Manas-36/VANITRA/docs/report/README.md

# Reports

| File | What |
|---|---|
| [Vanitra_Blue_Book_SCS_2025-26.pdf](Vanitra_Blue_Book_SCS_2025-26.pdf) | Project report (blue book), SCS mini project, AY 2025-26, guide Dr. Archana Belge |
| [Vanitra_Blue_Book_cover_and_index.pdf](Vanitra_Blue_Book_cover_and_index.pdf) | Cover page + chapter index template (6 chapters) |
| [paper/Vanitra_IEEE_paper_v2_Oct2025.pdf](paper/Vanitra_IEEE_paper_v2_Oct2025.pdf) | IEEE-format paper, latest version (Oct 2025) |
| [paper/Vanitra_IEEE_paper_v1_Aug2025.pdf](paper/Vanitra_IEEE_paper_v1_Aug2025.pdf) | First version (Aug 2025) |
| [ERRATA.md](ERRATA.md) | 21 fixes to make before resubmitting (pin counts, IMU, STT claim, captions, spelling, references) |

These describe the **first prototype** (breadboard glove + Wokwi). The v1.0 design in this repo differs where the errata say so; the design reasons are in [../decisions.md](../decisions.md).
When the v1.x hardware is measured ([../testing.md](../testing.md)), update Chapter 4 (pin map, schematics from `docs/wiring/`), Chapter 5 (new results) and the paper's Section VI.

Figures in `docs/images/` were extracted from these PDFs (CAD, prototype photos, Wokwi, old block diagrams `*_old.png`). The new schematics are in `docs/wiring/`.
