Manas-36/VANITRA/docs/images/README.md

# Images

Extracted from the 2025 blue book, IEEE paper and Hackanova deck.

| File | What |
|---|---|
| `prototype_glove.png`, `prototype_bench.png` | first breadboard prototype (SCS mini project) |
| `cad_glove.png`, `cad_wristband.png`, `cad_wristband_top.png` | CAD renders |
| `glove_labelled.png`, `wristband_labelled.png` | labelled component placement |
| `wokwi_glove.png`, `wokwi_wristband.png` | Wokwi simulations (old pin map) |
| `pcb_layout_glove.png` | early single-layer PCB layout (ESP32-S3-WROOM-1 + OLED header) |
| `comparison_table.png` | comparison with existing systems (paper Table 1) |
| `block_*_old.png`, `flow_*_old.png` | original block diagrams / flowcharts — superseded by `docs/wiring/system_overview.png` |
