Manas-36/VANITRA/docs/decisions.md

# Design decisions

Why the v1.0 design looks the way it does. Several decisions resolve contradictions between the SCS blue book, the IEEE paper and the Hackanova deck (listed in [report/ERRATA.md](report/ERRATA.md)).

## D1 — One pin map, owned by the firmware
**Problem.** The Hackanova deck put 5 flex sensors on "GPIO 4–7" (4 pins) and Hall sensors on "GPIO 9–13" (5 pins). The blue book said 2–4 Hall sensors.
**Decision.** Use **5 flex sensors on GPIO 4, 5, 6, 7, 8** and **4 Hall sensors on GPIO 9, 10, 1, 2**, all on ADC1 (ADC2 is not used). The pins are defined in `firmware/*/config.h`, and the schematics and [wiring.md](wiring.md) copy them. Four Hall sensors match the Wokwi model, which had 4 contact inputs.

## D2 — The IMU is a core sensor, not optional
**Problem.** The blue book called the MPU6050 "optional", while the paper and deck treat it as core.
**Decision.** It is **core**. Six of the 16 model features (roll, pitch, their change, gyro mean/max, accel spread) come from it. Without it, static hand shapes still work, but signs that differ only in motion (YES vs SORRY, GOOD vs BAD) cannot be told apart. The firmware still runs if the IMU is missing, so that wiring faults are easy to find.

## D3 — Analog Hall sensors (SS49E) instead of digital switches
The paper's formula is `if V_hall > V_threshold → contact`, which needs an analog output. Common A3144 switches also need ≥ 4.5 V. The **SS49E** is linear, runs on 3.3 V and is cheap. The firmware stores each sensor's no-magnet baseline during calibration and uses **|V − baseline|** with hysteresis (on > 250 mV, off < 150 mV), so either magnet pole works.

## D4 — The wristband recognises a fixed phrase list, not open dictation
**Problem.** The paper claimed "offline speech-to-text" with 85–90 % word accuracy on an ESP32-S3. General dictation on a microcontroller is not realistic, and judges will ask about it.
**Decision.** Use Espressif **ESP-SR** (WakeNet + MultiNet), which runs fully offline on the ESP32-S3 with PSRAM. It recognises up to 200 pre-defined phrases. v1.0 ships **49 phrases → 22 meanings** (`firmware/wristband_unit/phrases.csv`). This is the "keyword detection" framing the Hackanova deck already used. To add phrases, edit the CSV and run `tools/make_sr_commands.py`.

## D5 — Electret + preamp → INMP441 I2S microphone
ESP-SR expects clean 16 kHz digital audio over I2S. The INMP441 is digital, costs about the same as an electret + MAX9814, and avoids ADC noise. The wiring follows Espressif's reference example (SCK 17, WS 47, SD 16).

## D6 — Vibrate short codes, not whole sentences
At a comfortable 120 ms dot, Morse runs at about 10 words per minute, so a full sentence would take 15–30 s. Each meaning therefore has a **short code** of 1–6 characters ("are you okay" → `OK?`, "do you want water" → `WATER?`). A message takes **1–8 s** at normal speed (measured from `morse.h` timings). Danger phrases ("watch out") use a special pattern of three long buzzes that cannot be mistaken for a letter. There are three speeds (160/120/90 ms dot), changed by holding the button.
**Morse timing vs. the deck.** The deck said 50 ms dots and 150 ms dashes. A coin ERM motor needs about 30–50 ms just to spin up, so 50 ms dots are hard to feel. v1.0 starts at a 160 ms dot (learning) and lets the user speed up.

## D7 — The wristband output is haptic Morse, with optional OLED text
**Problem.** The reports said haptic Morse, but the deck's block diagram ended in "Text" and its plan mentioned "text on display".
**Decision.** **Morse vibration is the primary output** (silent, works without looking). A 0.96" OLED is **optional** on both units: on the wristband it shows the full sentence, and on the glove it shows the word being spoken so the signer can confirm it. The firmware detects at runtime whether an OLED is fitted.

## D8 — Glove speech = recorded clips over I2S, not a buzzer
The glove must say real words offline. Pre-made WAV clips (16 kHz mono, about 450 KB for 20 words) are embedded in flash and played through a **MAX98357A** I2S amplifier. `ml/make_voice_clips.py` creates them with espeak-ng, or from your own recordings, which sound much better. There is no runtime TTS and no SD card.

## D9 — Our own tiny neural network instead of TensorFlow Lite
The model is a 16→32→21 MLP (about 1,200 multiply-adds, well under 1 ms). It is exported by `ml/train.py` as plain C arrays (`model.h`) and run by about 40 lines of C++ (`mlp.h`). This avoids the TFLite toolchain, keeps the firmware easy to read, and lets the PC test check that the C++ output **matches Python to 1e-6**. TFLite Micro (bundled with core 3.x) remains an option if a 1D-CNN is needed for continuous signing.

## D10 — Window features instead of raw frames
The features are the mean flex per finger, the fraction of time each Hall sensor is in contact, roll/pitch and their change, and gyro mean/max and accel spread over **0.5 s**. They cover static signs (shape) and simple dynamic signs (motion) with only 16 numbers, which suits a small dataset collected by students. The window, features and model are all fixed in one place (`features.h` ↔ `vanitra_features.py`).

## D11 — REST class + confidence gate + stability
Real use is mostly "no sign". Without a REST class and a gate, the glove would talk all the time. A word is spoken only when the model says the same non-REST label with p ≥ 0.85 **three times in a row** (300 ms). The same word is not repeated unless the hand returns to REST or 2.5 s pass. All of these are `#define`s in `config.h`.

## D12 — Same board for both units
Both units use the **ESP32-S3-DevKitC-1 N16R8**. ESP-SR needs the PSRAM, the glove gets room for clips and future models, and one spare board covers both units.

## D13 — Power: 1S LiPo → TP4056 → MT3608 (5 V) → board 5V pin
These are cheap, easy-to-find modules. The board's own regulator makes 3.3 V. The amplifier runs directly from 5 V for volume. The battery voltage is read through a 100k/100k divider. Estimated runtime on 1000 mAh is about 8 h (glove) and about 5 h (wristband; ESP-SR keeps the CPU busy). These are estimates to be measured (see [testing.md](testing.md)).

## v2 decisions (Oct 2026), from the [design review](design_review_v2.md)

## D14 — Keep resistive flex sensors, but 4.5″ on the fingers and mounted properly
Alternatives were compared in the review. Finger IMUs cannot see bend when the palm faces sideways without gyro integration or magnetometers, and the fingertip magnets would upset magnetometers. Knuckle Hall sensors would cross-talk with those magnets. Capacitive sensors are too expensive. **Decision:** keep the 2.2″ sensor on the thumb and use **4.5″** on the index to little fingers, because they cover both knuckles and tolerate the glove shifting. Anchor only the pin end, slide the strip in a sleeve, and stiffen the pins. Divider **R = √(R_flat·R_bent)**: 22 kΩ for 4.5″ and 33 kΩ for 2.2″. Budget option: 2.2″ everywhere.

## D15 — 100 nF on every analog input
The ESP32-S3 SAR ADC samples onto a small internal capacitor through a multiplexer. Driven from a 7–15 kΩ Thevenin source, it does not settle fully between channels. A 100 nF capacitor at each pin acts as a charge reservoir, so the reading settles and neighbouring fingers stop leaking into each other. The corner frequency stays above 100 Hz, which is far faster than a finger moves.

## D16 — Glove power without a boost converter
**LiPo → TP4056 + DW01 → switch → VSYS → AP2112K-3.3 / ME6211C33 LDO → board 3V3 pin.** The MAX98357A runs from VSYS (2.5–5.5 V; about 0.8 W into 8 Ω at 3.7 V, which is enough for speech). The flex and Hall readings are ratiometric to 3V3, so the sensor rail should be quiet and steady. A linear regulator gives that, while a 1.2 MHz boost followed by an LDO does not. The cost is runtime: below about 3.5 V the LDO drops out, and the firmware warns at `VBAT_LOW_V`. The battery divider now sits after the switch. The wristband keeps its MT3608 for now.

## D17 — Say "sensor fault" instead of guessing
A flex pin stuck below 120 mV (open: cracked sensor or broken wire) or above 3150 mV (short) for more than 0.5 s sets a fault bit. The glove shows `SENSOR FAULT / FLEX n`, beeps and logs it, and `i` prints the fault mask. Low battery is reported the same way.

## D18 — Temporal CNN as the default model; the MLP stays selectable
The v1 MLP sees 0.5 s reduced to 16 averages, so it cannot tell the order of a movement and only sees part of most signs. **Decision:** use a 1D-CNN on 1.0 s of the raw 15-channel signal. It has 3 conv layers, global mean+max pooling and a dense layer, with about 10 k weights and about 0.23 M multiply-adds. It is trained in **NumPy** (`ml/vanitra_cnn.py`), with augmentation for speed, drift, IMU tilt and noise. It is exported as C arrays and run by `cnn.h`, with the same parity-test approach as D9. `GESTURE_MODEL` in `config.h` switches between the two. `train_cnn.py` scores both on the same folds, so the team ships whichever wins on real data.

## D19 — The glove unplugs from the cuff
**J1** (JST-PH 6p: 3V3 + 5 flex) and **J2** (JST-PH 6p: 3V3, GND, 4 Hall) carry the sensors. The IMU sits on the cuff side of **J3** (JST-SH 4p). The dividers and capacitors stay on the cuff. The fabric glove can then be washed, and a broken sensor can be swapped in minutes.

## D20 — A PC live decoder for demos and tuning
`ml/live_decoder.py` runs the exported CNN with the firmware's exact speaking rules on the serial stream, or on a recorded CSV. It shows live top-3 guesses and a transcript, and can speak aloud. It lets you demo on a projector and tune `CONF_THRESHOLD` / `STABLE_COUNT` without reflashing.

## v3 decisions (Oct 2026): two gloves, ISL grammar, phone camera, from [isl_language.md](isl_language.md)

## D21 — Two gloves, one firmware, ESP-NOW
ISL uses both hands, and most of its alphabet is two-handed, so a single glove caps the vocabulary. **Decision:** build a second, identical glove without the amp, speaker or OLED, and flash the **same sketch** on it. A serial command `r` stores its role (LEFT) in flash. The LEFT glove sends each calibrated frame (36-byte packet, 50 Hz, ESP-NOW broadcast filtered by `LINK_PAIR_ID`) to the RIGHT glove. The RIGHT glove runs the model on 30 channels. A frame older than 120 ms counts as "left missing" (zeros), and training randomly drops the left glove, so recognition degrades to one-handed instead of failing. No router or pairing is needed. Cost: the radio stays on, which roughly halves battery life (measure it). The left glove is about ₹6,500 extra.

## D22 — One ISL gloss vocabulary for gloves and camera
`ml/vocabulary.csv` now holds 58 ISL glosses + REST, chosen to cover everyday, health and emergency sentences, questions, negation and time. Gloves and camera share it, so their probabilities can be fused. Signs are copied from ISLRTC dictionary videos and are deliberately not described in text.

## D23 — Sentences: a sign spotter, a gloss language model, then rules
Continuous recognition is split into three explainable steps:
1. A **spotter** accepts a sign when the same gloss stays on top (confidence + stability), and keeps its top-4 guesses.
2. A **bigram gloss LM** (interpolated) with beam search picks the most plausible sequence. It may drop a shaky detection.
3. **Rule-based ISL → English** handles time→tense, SOV→SVO, wh/NOT at the end, MUST/CAN, FINISH, articles, possessives and infinitives.

Rules were chosen over a learned translator because there is no parallel data yet. Rules never invent meaning, and every output can be traced to its glosses. Swap in a learned model once thousands of signer-checked pairs exist (training_guide.md §7).

## D24 — Non-manual grammar comes from the camera
Yes/no questions (raised brows) and negation (head shake) are facial in ISL, and gloves cannot see the face. **Decision:** the camera measures them relative to the signer's own neutral face (median while not signing). With gloves only, the user signs the general `QUESTION` sign.

## D25 — The phone camera runs through the browser, decoded on the laptop
The phone page uses `getUserMedia` and needs HTTPS, so the laptop makes a self-signed certificate for its LAN IPs. It sends JPEG frames over a WebSocket with at most 2 in flight, which keeps latency low. The laptop sends back glosses and sentences, which the phone shows and speaks (speechSynthesis). No app is needed. Any OpenCV source (DroidCam, IP Webcam, files) also works. Only landmark features are stored, never images.

## D26 — Camera features are in signing space
MediaPipe Tasks (hands ×2, pose, face blendshapes + head pose) produce 148 features:
- coordinates in a body frame (shoulder midpoint, shoulder width, an x axis from the right to the left shoulder, y down), which makes them invariant to position, distance and mirroring;
- handshape in a wrist-centred frame scaled by hand size;
- hands ordered dominant / non-dominant by matching the pose wrists;
- resampling to 25 Hz, with drop-outs up to 150 ms bridged.

The sign model is the same NumPy CNN family as the gloves (1.6 s window, 96/128/128 filters), so there is one code base to test.

## D27 — Glove + camera fusion is a weighted product of probabilities
`p ∝ p_cam^w · p_glove^(1−w)` on the shared vocabulary, with `w = 0.5` by default and tuned on a validation signer. The two sensors fail differently: gloves miss location and the face, the camera misses occluded fingers and struggles in bad light.

## Open questions
- ~~ASL or ISL?~~ **Decided in v3: ISL** (D22). Remaining question: which regional ISL variant your users sign. The vocabulary uses one-handed ASL-style signs because the glove is on one hand. For Indian users, an **ISL** vocabulary is the obvious next step: change `ml/vocabulary.csv` and record new data. No code changes are needed.
- Should the glove and wristband talk to each other (ESP-NOW)? Useful for confirming spoken words on the wrist. Planned for v2.0.
