Manas-36/VANITRA/docs/report/Vanitra_Blue_Book_cover_and_index.pdf

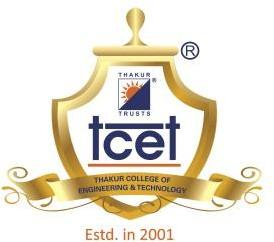
[picture p51: figure]

### Project Report

on

# VANITRA: A Wearable Assistive Device for Bidirectional Deaf–Mute Communication

Submitted in partial fulfilment for the award of the degree of

## BACHELOR OF ENGINEERING

In

## MECHANICAL AND MECHATRONICS ENGINEERING

Submitted by
Shubham Chamedia (2)
Pragati Jha (16)
Manas Pednekar (36)

Under the Guidance of
Dr. Archana Belge
Head of Department

Department of Mechanical and Mechatronics Engineering (Academic Year. 2025-26)

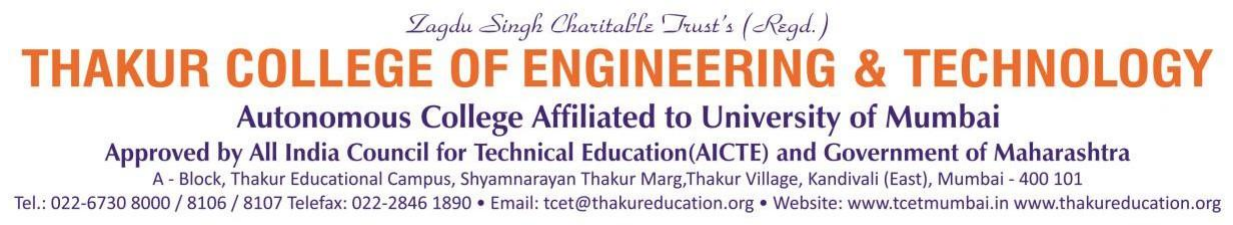
[picture p52: figure]

## Index

Chapter No.: | Topic | Page No.
| Abstract | 1
Chapter 1 | Introduction
| 1.1 Overview of the Project | 2
| 1.2 Motivation & Application | 2
| 1.3 Problem Definition | 2
| 1.4 Objective & Scope | 2
| 1.5 Expected Outcome | 3
| 1.6 Organization of the Report | 3
Chapter 2 | Literature Survey & Proposed System
| 2.1 Literature review of Existing System | 3
| 2.2 Limitations of Existing System & Gap Analysis | 4
| 2.3 Proposed System | 4
Chapter 3 | Requirement Gathering, Analysis and Planning
| 3.1 Requirement Specification | 5
| 3.2 Feasibility Study | 5
| 3.3 Methodology | 6
| 3.4 Technology Stack | 6
| 3.5 Gantt Chart and Process Model | 7
| 3.6 System Analysis (Functional, Structural, and
| Behavioural Models) | 7
| 3.7 Risk Assessment and Mitigation | 8
| 3.8Acceptance Criteria and KPIs | 8
Chapter 4 | System Design and Experimental Set up
| 4.1 System Architecture & Diagrams (DFD/UML/ Block
| Diagram/Physical Layout) | 9
| 4.2 Algorithm & Process flow design (Flowchart/Pseudo
| Code) | 10
| 4.3 User Interface & Input Data Design (Snapshots/
| circuits/Structure) | 11

4.4 Experimental Setup and Tools (Software & Hardware) 12
| 4.5 Implementation, Deployment and Testing | 12
| 4.6 Performance Evaluation. | 13
| 4.7 Summary | 13
Chapter 5 | Results & Discussion
| 5.1 Outputs & Outcomes | 14
| 5.2 Analysis of Results & Interpretation of data | 14
| 5.3 Discussion of Results & Limitations of the System | 15
Chapter 6 | Conclusion & Future Scope
| 6.1 Summary of work completed | 16
| 6.2 Future Scope | 16
| References | 17
| Research Paper
