Manas-36/VANITRA/docs/images/pcb_layout_glove.png

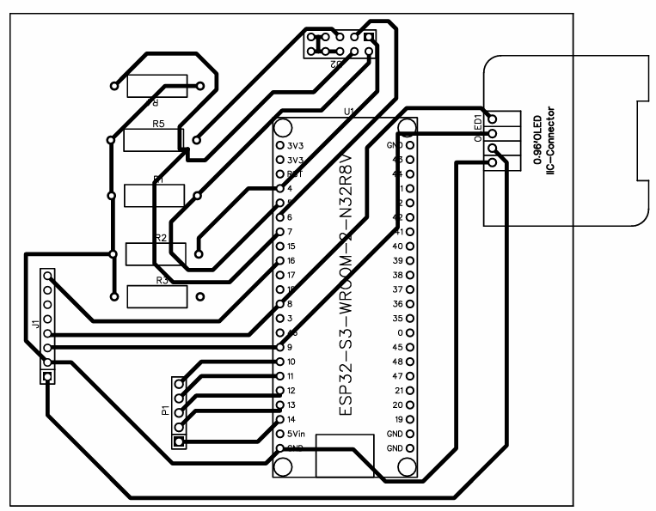
docs/images/pcb_layout_glove.png
