Manas-36/VANITRA/docs/images/wristband_labelled.png

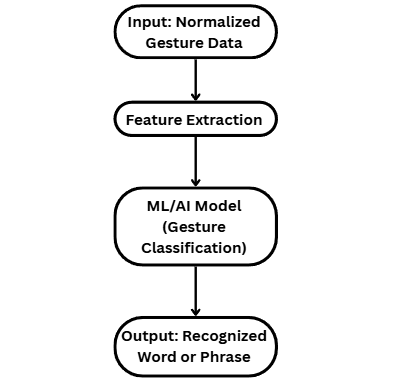
docs/images/wristband_labelled.png
