Manas-36/VANITRA/docs/wiring.md

# Wiring

The schematics are generated by `docs/wiring/make_schematics.py`; re-run it after changing a pin. The SVG files can be zoomed without losing quality. Use the PNG files for slides, the report and Notion. The pins are copied from `firmware/glove_unit/config.h` and `firmware/wristband_unit/config.h`, which are the source of truth.

## System
System overview

## Glove unit (hardware v2)
Glove schematic

v2 changes are explained in the [design review](design_review_v2.md). The v1 drawing is kept as [glove_unit_v1.png](wiring/glove_unit_v1.png).

| Part | Part pin | ESP32-S3 | Notes |
|---|---|---|---|
| Flex thumb (2.2″) | one leg → 3V3, other leg → J1 → **GPIO4**, with **33 kΩ** and **100 nF** → GND on the cuff | GPIO4 (ADC1_CH3) | voltage divider |
| Flex index (4.5″) | same, **22 kΩ** + 100 nF | GPIO5 (ADC1_CH4) | |
| Flex middle (4.5″) | same, 22 kΩ + 100 nF | GPIO6 (ADC1_CH5) | |
| Flex ring (4.5″) | same, 22 kΩ + 100 nF | GPIO7 (ADC1_CH6) | |
| Flex little (4.5″) | same, 22 kΩ + 100 nF | GPIO8 (ADC1_CH7) | |
| SS49E H1 (thumb tip) | VCC 3V3 · GND · OUT → J2 → 100 nF | GPIO9 (ADC1_CH8) | flat face towards the magnet; 100 nF VCC–GND at the sensor |
| SS49E H2 (thumb side, index contact) | OUT | GPIO10 (ADC1_CH9) | |
| SS49E H3 (palm centre, curled fingertips) | OUT | GPIO1 (ADC1_CH0) | |
| SS49E H4 (side of index, touches middle) | OUT | GPIO2 (ADC1_CH1) | |
| MPU6050 (GY-521) | VCC 3V3 · GND · SDA · SCL · AD0 → GND | SDA **GPIO16**, SCL **GPIO17** | address 0x68, back of hand |
| SSD1306 OLED (optional) | VCC 3V3 · GND · SDA · SCL | same I2C bus | address 0x3C |
| MAX98357A | BCLK · LRC · DIN · SD | GPIO12 · GPIO13 · GPIO14 · GPIO21 | **VIN = VSYS (battery after switch) + 100 µF**, GND, GAIN open (9 dB) |
| Speaker | OUT+ / OUT− of the amp | — | 4–8 Ω, never to GND |
| Battery sense | **VSYS** (after the switch) → 100k → **GPIO3** → 100k ∥ 100 nF → GND | GPIO3 (ADC1_CH2) | reads half the battery voltage; no drain when switched off |
| Harness | J1 JST-PH 6p (3V3, F1–F5) · J2 JST-PH 6p (3V3, GND, H1–H4) · J3 JST-SH 4p (MPU6050) | — | the glove unplugs from the cuff for washing / repair |
| BOOT button | on the board | GPIO0 | short = repeat word, hold 2 s = calibrate |
| RGB LED | on the board | GPIO48 (v1.0 board) / GPIO38 (v1.1) | `RGB_BUILTIN` picks the right one |

**Placement on the glove:** flex sensors run along the back of each finger, with the printed side facing out. **Anchor only the pin end** at the knuckle and stiffen the pins (heat-shrink + a small stiffener). The strip slides in a sewn sleeve, with the tip free. Never glue it along its length. Use silicone multi-strand wire. Put **magnets on the fingertips** (index, middle, ring, little) and the **Hall sensors on the thumb tip, the thumb side, the palm centre and between the index and middle fingers**. The MPU6050 goes flat on the back of the hand. The ESP32, amplifier and battery go on the wrist cuff, with the speaker facing outwards.

## Left glove (v3, two-glove mode)
The left glove is the **same circuit as the glove above, without** the MAX98357A, speaker and OLED. It has the same pins, so `config.h` is unchanged. Flash the same `glove_unit` sketch, then type `r` in the serial monitor once. The LED turns **blue** (LEFT) and the right glove stays **green** (RIGHT). The left glove sends its frames over ESP-NOW (Wi-Fi channel `LINK_CHANNEL`, filtered by `LINK_PAIR_ID`). Type `i` on the right glove to see the link: frames received, frames lost, age of the last frame. Any ESP32-S3 board that brings out GPIO 1–10, 16, 17 works for the left glove; it does not need PSRAM.

## Wristband unit
Wristband schematic

| Part | Part pin | ESP32-S3 | Notes |
|---|---|---|---|
| INMP441 mic | SCK | **GPIO17** | |
| | WS | **GPIO47** | |
| | SD | **GPIO16** | mic data out → ESP32 in |
| | L/R | GND | left channel |
| | VDD / GND | 3V3 / GND | |
| Vibration motor driver | MOSFET gate via 100 Ω, 100 kΩ gate → GND | **GPIO4** (PWM 5 kHz) | motor between 3V3 and drain, diode across motor (cathode to 3V3) |
| LISTEN button | one leg → GPIO5, other → GND | **GPIO5** | internal pull-up |
| SSD1306 OLED (optional) | SDA / SCL | **GPIO8 / GPIO9** | 0x3C |
| Battery sense | 100k / 100k divider | **GPIO1** | |
| RGB LED | on the board | GPIO48 | |

Keep the microphone on the outside of the band and the motor on the inside, against the skin. The firmware pauses listening while the motor runs.

## Power
**Glove (v2):** LiPo 3.7 V → **TP4056 + DW01** (USB-C, with protection) → slide switch → **VSYS** → **AP2112K-3.3 / ME6211C33** LDO (10 µF in and out) → board **3V3** pin. VSYS also feeds the MAX98357A. There is no boost converter, so the sensor rail is quiet. Leave the board's 5V pin free. Below about 3.5 V the LDO drops out and the firmware warns.

**Wristband:** LiPo 3.7 V → **TP4056** → slide switch → **MT3608** boost → set to **5.0 V before connecting** → board **5V** pin.
Do not power the board from USB and the boost converter at the same time unless there is a diode on the 5 V line. The simplest rule is to switch the battery off while the USB cable is plugged in.

## Pins to avoid on the ESP32-S3-DevKitC-1 N16R8
- GPIO 35, 36, 37: used by the octal PSRAM
- GPIO 19, 20: USB
- GPIO 0, 3, 45, 46: strapping pins (GPIO0 is only used as the BOOT button, and GPIO3 only for battery sensing through a divider)
- ADC2 (GPIO 11–20): not used for analog
