Manas-36/VANITRA/docs/wiring/glove_unit_v1.png

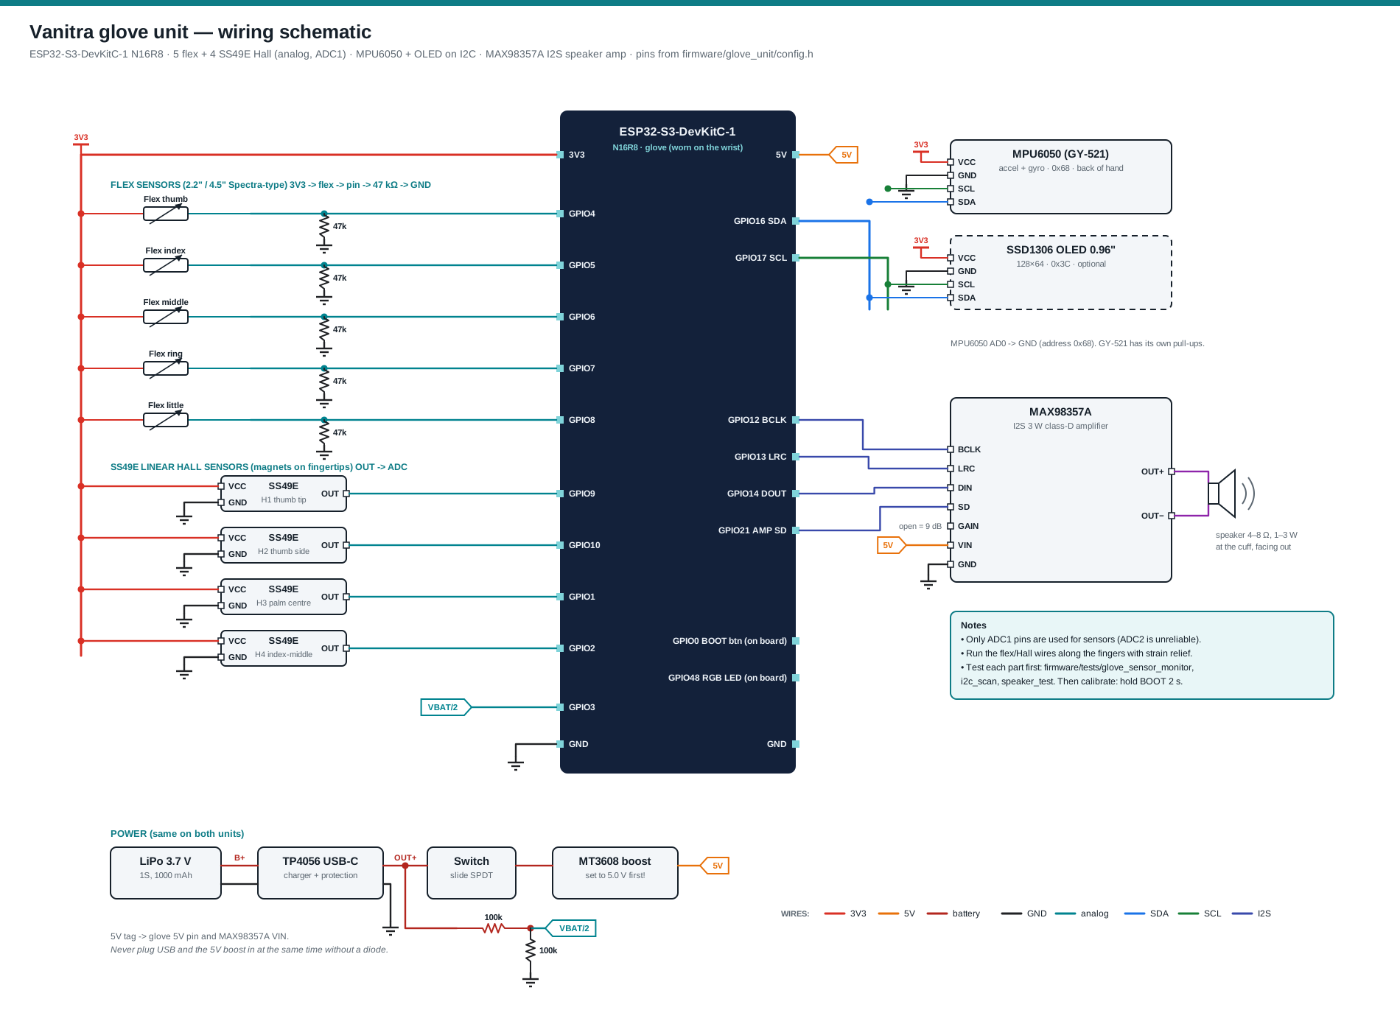
docs/wiring/glove_unit_v1.png
