Manas-36/VANITRA/firmware/glove_unit/glove_unit.ino

// =====================================================================================
//  VANITRA — glove unit (gesture -> speech)
//  5 flex + 4 Hall (SS49E) + MPU6050  ->  1.0 s window  ->  on-device temporal CNN (v2)  ->  voice clip
//  (set GESTURE_MODEL in config.h to GESTURE_MODEL_MLP for the v1 feature MLP)
//  Board: ESP32-S3-DevKitC-1 N16R8 · Arduino IDE, esp32 core 3.x · "ESP32S3 Dev Module"
//  Tools: Flash 16MB, PSRAM OPI, Partition "16M Flash (3MB APP/9.9MB FATFS)", USB CDC On Boot: Enabled
//  Libraries: Adafruit SSD1306 + Adafruit GFX (only if HAS_OLED 1)
//
//  Two gloves (v3): flash this SAME sketch on both; type 'r' on the left one to make it role LEFT.
//  The LEFT glove only measures and radios its frames (ESP-NOW); the RIGHT glove runs the model on both
//  hands, speaks, and streams both hands over USB.
//
//  Serial (115200): h help · c calibrate · s/x stream raw frames on/off (for ml/collect_data.py)
//                   p predictions on/off · i info · r toggle role RIGHT/LEFT (restarts)
// =====================================================================================
#include "config.h"
#include "features.h"
#include "classifier.h"
#include "sensors.h"
#include "voice.h"
#include "display.h"
#include "glove_link.h"
#include <Preferences.h>

enum Role : uint8_t { ROLE_RIGHT = 0, ROLE_LEFT = 1 };
static Role role = ROLE_RIGHT;
static bool linkOk = false;

static bool streaming = false, printPred = false;
static uint32_t frameNo = 0, nextFrameUs = 0;

// recognition state
static int candidate = -1, candidateCount = 0, lastSpoken = -1;
static bool restSinceLast = true;
static uint32_t lastSpokenMs = 0, cooldownUntil = 0;

// ------------------------------------------------------------------ status LED
static void led(uint8_t r, uint8_t g, uint8_t b) { rgbLedWrite(STATUS_LED, r, g, b); }
static void ledIdle() {
  if (streaming) led(12, 0, 12);
  else if (!cal.valid) led(14, 0, 0);
  else if (role == ROLE_LEFT) led(0, 0, 14);          // LEFT glove: blue
  else led(0, 10, 0);                                 // RIGHT glove: green
}

static void loadRole() {
  Preferences p;
  p.begin("vanitra", true);
  role = (Role)p.getUChar("role", ROLE_RIGHT);
  p.end();
}

static void toggleRole() {
  Preferences p;
  p.begin("vanitra", false);
  p.putUChar("role", role == ROLE_RIGHT ? ROLE_LEFT : ROLE_RIGHT);
  p.end();
  Serial.println("[role] changed - restarting");
  delay(200);
  ESP.restart();
}

// ------------------------------------------------------------------ calibration
static void countdown(const char *what, uint8_t r, uint8_t g, uint8_t b) {
  Serial.printf("[cal] %s ...\n", what);
  displayShow("CALIBRATION", what, "get ready");
  for (int i = 0; i < 4; i++) { led(r, g, b); delay(250); led(0, 0, 0); delay(250); }
  led(r, g, b);
  displayShow("CALIBRATION", what, "hold still...");
}

static void runCalibration() {
  float flex[5], hall[4], gyro[3];
  countdown("OPEN HAND", 0, 0, 40);          // fingers straight, magnets away, hand still
  averageChannels(3000, flex, hall, gyro);
  for (int i = 0; i < 5; i++) cal.flexStraight[i] = flex[i];
  for (int i = 0; i < 4; i++) cal.hallBase[i] = hall[i];
  for (int i = 0; i < 3; i++) cal.gyroBias[i] = gyro[i];

  countdown("MAKE A FIST", 40, 25, 0);
  averageChannels(3000, flex, hall, gyro);
  bool ok = true;
  for (int i = 0; i < 5; i++) {
    cal.flexBent[i] = flex[i];
    float span = cal.flexBent[i] - cal.flexStraight[i];
    Serial.printf("[cal] flex %d: straight %.0f mV, bent %.0f mV, span %.0f mV\n", i + 1, cal.flexStraight[i], cal.flexBent[i], span);
    if (fabsf(span) < 150) { ok = false; Serial.printf("[cal]   ! flex %d barely changes - check wiring / divider\n", i + 1); }
  }
  for (int i = 0; i < 4; i++) Serial.printf("[cal] hall %d baseline %.0f mV\n", i + 1, cal.hallBase[i]);
  calSave();
  clsClear();
  displayShow("CALIBRATION", ok ? "DONE" : "CHECK FLEX", ok ? "saved" : "see serial log");
  led(0, 40, 0); delay(600);
  ledIdle();
}

// ------------------------------------------------------------------ speaking
static void speak(int k, float p) {
  Serial.printf("SAY,%s,%.2f\n", CLS_LABELS[k], p);
  char foot[24];
  snprintf(foot, sizeof foot, "conf %d%%", (int)(p * 100));
  displayShow("VANITRA SAYS", CLS_SAY[k], foot);
  led(0, 30, 30);
  voiceSay(CLS_VOCAB_INDEX[k]);
  ledIdle();
  lastSpoken = k;
  lastSpokenMs = millis();
  restSinceLast = false;
  cooldownUntil = millis() + SPEAK_COOLDOWN_MS;
  candidate = -1; candidateCount = 0;
  clsClear();              // the speaking time is not part of the next gesture
}

// Confidence gate + stability (hysteresis) so the voice never flickers between words.
static void onPrediction(int k, float p) {
  if (printPred) Serial.printf("P,%s,%.2f\n", CLS_LABELS[k], p);
  if (k == CLS_REST_INDEX) { restSinceLast = true; candidate = -1; candidateCount = 0; return; }
  if (p < CONF_THRESHOLD || millis() < cooldownUntil) { candidateCount = 0; return; }
  if (k == candidate) candidateCount++;
  else { candidate = k; candidateCount = 1; }
  if (candidateCount < STABLE_COUNT) return;
  bool repeat = (k == lastSpoken) && !restSinceLast && (millis() - lastSpokenMs < REPEAT_GAP_MS);
  if (!repeat) speak(k, p);
}

// ------------------------------------------------------------------ health (v2)
// Warn once when a flex sensor breaks or the battery is low, instead of silently guessing words.
static void checkHealth() {
  static uint8_t reported = 0;
  static uint32_t lastBattCheck = 0;
  static bool battWarned = false;
  if (flexFault & ~reported) {
    for (int i = 0; i < 5; i++)
      if ((flexFault & ~reported) & (1 << i)) {
        Serial.printf("[fault] flex %d reads open/short - check the sensor and its connector\n", i + 1);
        char msg[16];
        snprintf(msg, sizeof msg, "FLEX %d", i + 1);
        displayShow("SENSOR FAULT", msg, "check connector");
        voiceBeep(330, 200);
      }
    reported |= flexFault;
  }
  reported &= flexFault | 0xE0;          // forget repaired sensors so a new break is reported again
  if (millis() - lastBattCheck > 10000) {
    lastBattCheck = millis();
    float v = batteryVolts();
    if (v > 2.5f && v < VBAT_LOW_V && !battWarned) {   // > 2.5 V: ignore when running from USB only
      battWarned = true;
      Serial.printf("[power] battery low: %.2f V - charge soon\n", v);
      displayShow("BATTERY LOW", "charge soon", "");
      voiceBeep(440, 120); voiceBeep(330, 120);
    } else if (v > VBAT_LOW_V + 0.1f) battWarned = false;
  }
}

// ------------------------------------------------------------------ serial commands
static void printHelp() {
  Serial.println(F("Vanitra glove — commands: h help | c calibrate | s stream on | x stream off | "
                   "p predictions on/off | i info | r role RIGHT/LEFT"));
}

static void printInfo() {
  Serial.printf("[info] model: %s, %d classes (%s)%s\n", CLS_NAME, CLS_N_OUT, CLS_INFO,
                CLS_PLACEHOLDER ? " *** PLACEHOLDER - retrain on real data ***" : "");
  Serial.printf("[info] flex faults: 0x%02X\n", flexFault);
  uint32_t rxN, lost, age;
  glink::stats(rxN, lost, age);
  Serial.printf("[info] role %s, link %s, left frames %lu (lost %lu, last %ld ms ago)\n",
                role == ROLE_LEFT ? "LEFT (sender)" : "RIGHT (main)", linkOk ? "up" : "FAILED",
                (unsigned long)rxN, (unsigned long)lost, age == 0xFFFFFFFF ? -1L : (long)age);
  Serial.printf("[info] IMU %s, calibration %s, battery %.2f V\n", imuOk ? "ok" : "MISSING", cal.valid ? "saved" : "DEFAULT", batteryVolts());
  for (int i = 0; i < 5; i++) Serial.printf("[info] flex %d straight %.0f bent %.0f mV\n", i + 1, cal.flexStraight[i], cal.flexBent[i]);
  for (int i = 0; i < 4; i++) Serial.printf("[info] hall %d base %.0f mV\n", i + 1, cal.hallBase[i]);
}

static void handleSerial() {
  if (!Serial.available()) return;
  char c = Serial.read();
  switch (c) {
    case 'h': printHelp(); break;
    case 'c': runCalibration(); break;
    case 's': streaming = true; Serial.println("[stream] on"); ledIdle(); break;
    case 'x': streaming = false; Serial.println("[stream] off"); ledIdle(); break;
    case 'p': printPred = !printPred; break;
    case 'i': printInfo(); break;
    case 'r': toggleRole(); break;
    default: break;
  }
}

// ------------------------------------------------------------------ BOOT button
static void handleButton() {
  static uint32_t downAt = 0;
  static bool wasDown = false, longDone = false;
  bool down = digitalRead(BUTTON_PIN) == LOW;
  if (down && !wasDown) { downAt = millis(); longDone = false; }
  if (down && !longDone && millis() - downAt > 2000) { longDone = true; runCalibration(); }
  if (!down && wasDown && !longDone && millis() - downAt > 40) {
    if (lastSpoken >= 0) speak(lastSpoken, 1.0f);    // repeat last word
  }
  wasDown = down;
}

// ------------------------------------------------------------------ USB stream (ml/collect_data.py)
// One glove: D,t,15 values. Two gloves: D,t,15 right,15 left,left_ok (left = 0 when the link is down).
static void printHand(const vf::Sample &s) {
  for (int i = 0; i < 5; i++) Serial.printf(",%.4f", s.flex[i]);
  for (int i = 0; i < 4; i++) Serial.printf(",%.0f", s.hall[i]);
  Serial.printf(",%.3f,%.3f,%.3f,%.1f,%.1f,%.1f", s.ax, s.ay, s.az, s.gx, s.gy, s.gz);
}

static void printFrame(const vf::Sample &right, const vf::Sample *left, bool both) {
  Serial.printf("D,%lu", (unsigned long)millis());
  printHand(right);
  if (both) {
    vf::Sample zero = {};
    printHand(left ? *left : zero);
    Serial.printf(",%d", left ? 1 : 0);
  }
  Serial.print("\n");
}

// ------------------------------------------------------------------ setup / loop
void setup() {
  Serial.begin(115200);
  pinMode(BUTTON_PIN, INPUT_PULLUP);
  loadRole();
  sensorsBegin();
  displayBegin();
  voiceBegin();
  linkOk = glink::begin(role == ROLE_LEFT);
  led(0, 0, 30);
  Serial.printf("\nVANITRA glove ready (%s). IMU: %s. Calibration: %s. Link: %s.\n",
                role == ROLE_LEFT ? "LEFT - sender" : "RIGHT - main", imuOk ? "ok" : "MISSING",
                cal.valid ? "loaded" : "not done (hold BOOT 2 s)", linkOk ? "up" : "FAILED");
  printHelp();
  displayShow("VANITRA", role == ROLE_LEFT ? "LEFT" : "READY", cal.valid ? "glove unit" : "hold BOOT: calibrate");
  voiceBeep(660, 80); voiceBeep(990, 80);
  ledIdle();
  nextFrameUs = micros();
}

void loop() {
  handleSerial();
  handleButton();

  if ((int32_t)(micros() - nextFrameUs) < 0) return;
  if (micros() - nextFrameUs > 100000UL) nextFrameUs = micros();   // resync after speaking
  nextFrameUs += 1000000UL / SAMPLE_HZ;

  vf::Sample s;
  readFrame(s);
  frameNo++;
  checkHealth();

  if (role == ROLE_LEFT) {                    // LEFT glove: measure, send, done
    glink::send(s);
    if (streaming) printFrame(s, nullptr, false);
    return;
  }

  vf::Sample left;
  bool leftOk = glink::latest(left);
  clsPush(s, leftOk ? &left : nullptr);
  if (streaming) printFrame(s, leftOk ? &left : nullptr, TWO_GLOVES);

  if (clsReady() && frameNo % CLASSIFY_EVERY == 0) {
    float probs[CLS_N_OUT];
    int k = clsPredict(probs);
    if (!streaming) onPrediction(k, probs[k]);
  }
}
