Manas-36/VANITRA/firmware/glove_unit/classifier.h

// Vanitra glove — picks the gesture model at compile time (config.h: GESTURE_MODEL).
//   GESTURE_MODEL_CNN (default, v2): 1.0 s of raw frames -> temporal CNN (cnn.h + model_cnn.h)
//   GESTURE_MODEL_MLP (v1)         : 0.5 s -> 16 features -> MLP       (mlp.h + model.h)
// The rest of the sketch only uses the CLS_* names below, so both models drop in.
#pragma once
#include "config.h"
#include "features.h"

#if GESTURE_MODEL == GESTURE_MODEL_CNN
#include "cnn.h"
#define CLS_N_OUT        VC_N_OUT
#define CLS_REST_INDEX   VC_REST_INDEX
#define CLS_LABELS       VC_LABELS
#define CLS_SAY          VC_SAY
#define CLS_VOCAB_INDEX  VC_VOCAB_INDEX
#define CLS_INFO         VC_INFO
#define CLS_PLACEHOLDER  VC_PLACEHOLDER
#define CLS_NAME         "temporal CNN v2 (1.0 s window)"
static vc::SeqWindow clsWin;
// Channel layout = ml/vanitra_cnn.py CHANNELS_2: right glove 15, then (two-glove model) left glove 15.
static void sampleToChannels(const vf::Sample &s, float *o) {
  for (int i = 0; i < 5; i++) o[i] = s.flex[i];
  for (int i = 0; i < 4; i++) o[5 + i] = s.hall[i];
  o[9] = s.ax; o[10] = s.ay; o[11] = s.az;
  o[12] = s.gx; o[13] = s.gy; o[14] = s.gz;
}
static void clsPush(const vf::Sample &right, const vf::Sample *left) {
  float ch[VC_N_CH > 30 ? VC_N_CH : 30] = {0};
  sampleToChannels(right, ch);
  if (VC_N_CH >= 30 && left) sampleToChannels(*left, ch + 15);   // missing left glove stays 0
  clsWin.push(ch);
}
static void clsClear() { clsWin.clear(); }
static bool clsReady() { return clsWin.full(); }
static int clsPredict(float *probs) { return vc::cnnPredict(clsWin, probs); }
#else
#include "mlp.h"
#define CLS_N_OUT        VM_N_OUT
#define CLS_REST_INDEX   VM_REST_INDEX
#define CLS_LABELS       VM_LABELS
#define CLS_SAY          VM_SAY
#define CLS_VOCAB_INDEX  VM_VOCAB_INDEX
#define CLS_INFO         VM_INFO
#define CLS_PLACEHOLDER  VM_PLACEHOLDER
#define CLS_NAME         "feature MLP v1 (0.5 s window)"
static vf::Window clsWin;
static void clsPush(const vf::Sample &right, const vf::Sample *) { clsWin.push(right); }   // right glove only
static void clsClear() { clsWin.clear(); }
static bool clsReady() { return clsWin.full(); }
static int clsPredict(float *probs) {
  float f[vf::N_FEAT];
  vf::computeFeatures(clsWin, f);
  return vf::mlpPredict(f, probs);
}
#endif
