Manas-36/VANITRA/(commit log)

2026-10-16 Vanitra v1.0: firmware, ML pipeline, schematics, docs
    - Glove unit (ESP32-S3): 5 flex + 4 SS49E Hall + MPU6050, per-user
    calibration, 16-feature 0.5 s window, on-chip MLP, confidence gate,
    I2S voice clips, optional OLED
    - Wristband unit (ESP32-S3 + ESP-SR): offline wake word + 49 phrases,
    Morse short codes, 3 speeds, button, optional OLED
    - ML: data collection, grouped cross-validation, export to model.h,
    voice clips, synthetic data (shipped model is a placeholder)
    - PC unit tests (Python/C++ parity, Morse timing), hardware test sketches,
    Wokwi diagram
    - One consistent pin map, schematics (SVG/PNG), BOM, setup / wiring /
    architecture / ML / testing / decisions docs, report errata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
    [bom.csv, phrases.csv, vocabulary.csv]
2026-10-18 v2.0-dev: design review, glove hardware v2, temporal CNN decoder
    - docs/design_review_v2.md: 13 problems ranked; flex sensor kept but upgraded
    (4.5" fingers, mounting rules), alternatives compared
    - Glove schematic v2: 22k/33k dividers, 100 nF on every analog input,
    LiPo -> LDO -> 3V3 (no MT3608 on the glove), amp on VSYS, battery divider
    after the switch, J1/J2/J3 plug-in harness; v1 drawing kept as glove_unit_v1
    - ml/vanitra_cnn.py + train_cnn.py: NumPy 1D-CNN with drift/speed/tilt
    augmentation, CNN vs MLP report (clean + drifted, --by-user)
    - firmware: cnn.h + model_cnn.h (placeholder, synthetic), classifier.h model
    switch, flex open/short fault and low-battery warnings
    - ml/liv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
    [bom.csv]
2026-10-19 v3.0-dev: two gloves, ISL grammar engine, phone-camera decoder
    - docs/isl_language.md: how ISL works (parameters, two-handed signs, grammar,
    facial grammar) and what gloves vs camera can capture
    - two gloves: same firmware, role via serial 'r', ESP-NOW link (glove_link.h),
    30-channel CNN with left-glove dropout, 31-column stream
    - ISL vocabulary (58 glosses + REST) shared by gloves and camera; voice clips
    - lang/vanitra_lang: lexicon, phrases, gloss corpus, interpolated bigram LM +
    beam search over n-best, rule-based ISL -> English, non-manual markers
    - camera/: phone browser bridge (HTTPS/WebSocket, text + speech back),
    MediaPipe hands/pose/face -> 148 signing-space features, record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
    [bom.csv, isl_lexicon.csv, phrases.csv, vocabulary.csv]
2026-10-19 phone_bridge: print the Wi-Fi address first, mark virtual adapters
    Claude-Session: https://claude.ai/code/session_016PhX6qTbAGzqkfWPjEybnt
