Manas-36/VANITRA/(notices)

Notices in the files:
README.md:
License: MIT
